Rajmali-22/fpga-zebra-crossing-camera/demo_photos/none_02.jpg

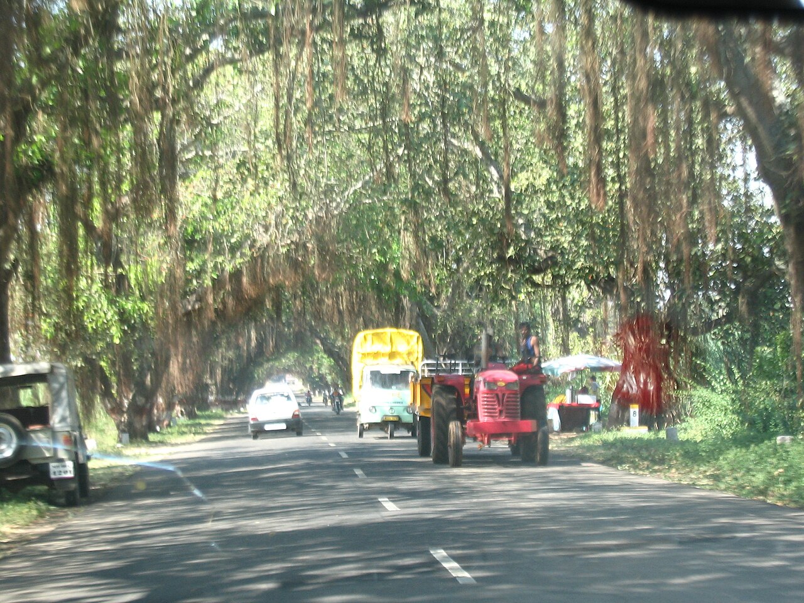
demo_photos/none_02.jpg
