Rajmali-22/fpga-zebra-crossing-camera/demo_photos/zebra_01.jpg

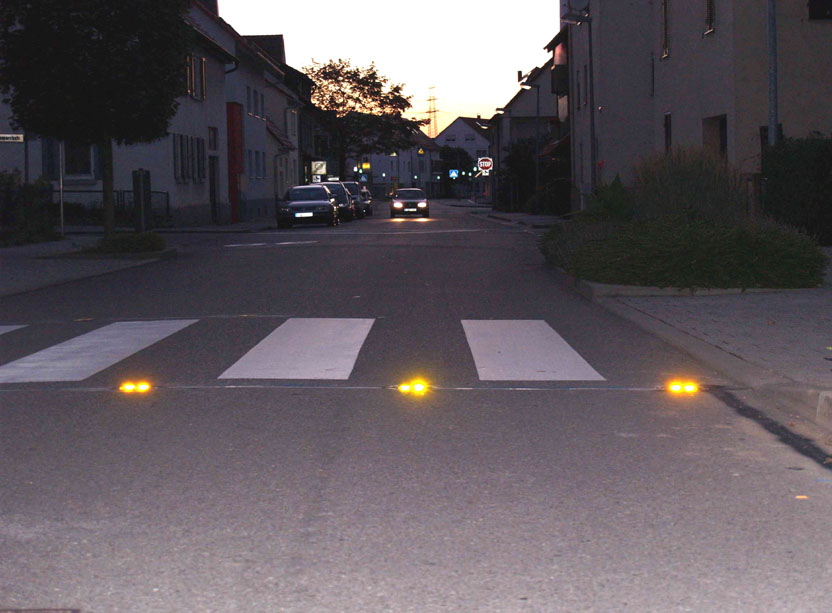
demo_photos/zebra_01.jpg
