Rajmali-22/fpga-zebra-crossing-camera/demo_photos/zebra_07.jpg

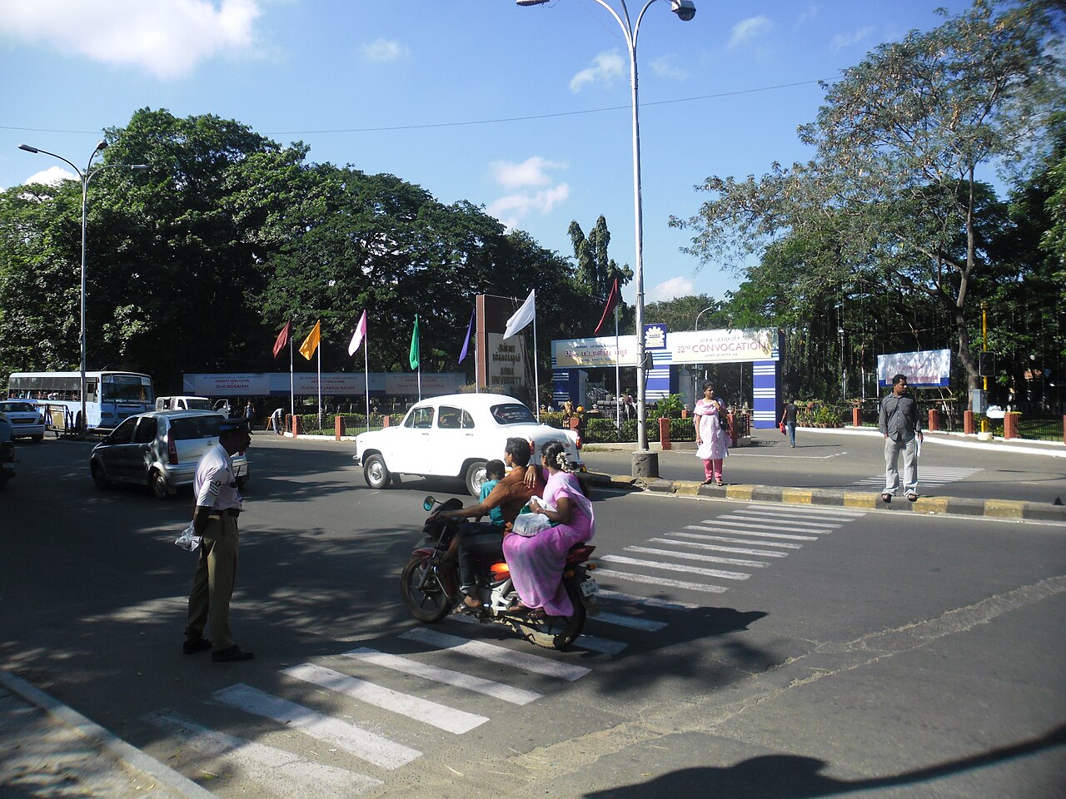
demo_photos/zebra_07.jpg
