Rajmali-22/fpga-zebra-crossing-camera/docs/fake_capture.png

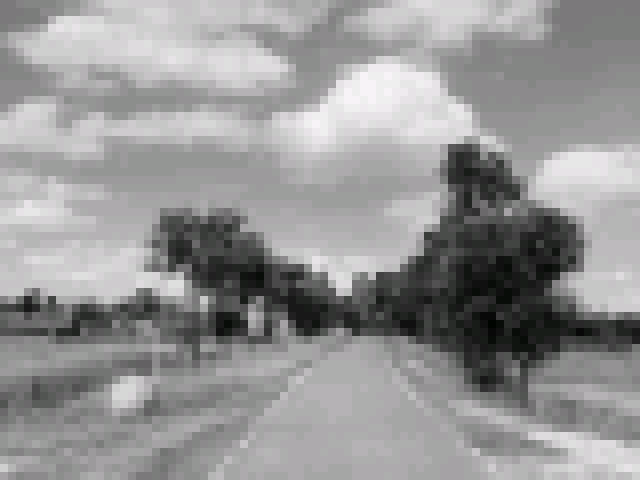
docs/fake_capture.png
