Rajmali-22/fpga-zebra-crossing-camera/docs/fig_architecture.png

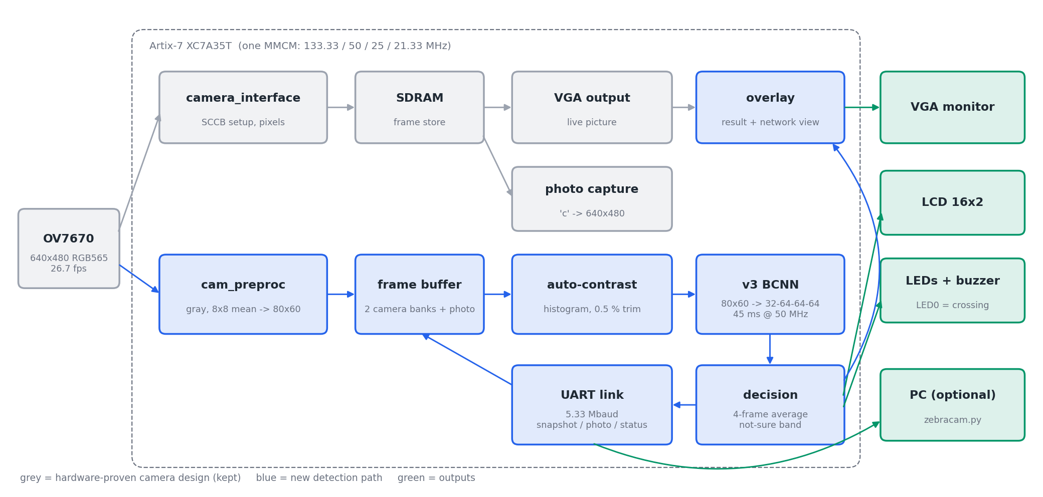
docs/fig_architecture.png
