Rajmali-22/fpga-zebra-crossing-camera/docs/fig_real_frame.png

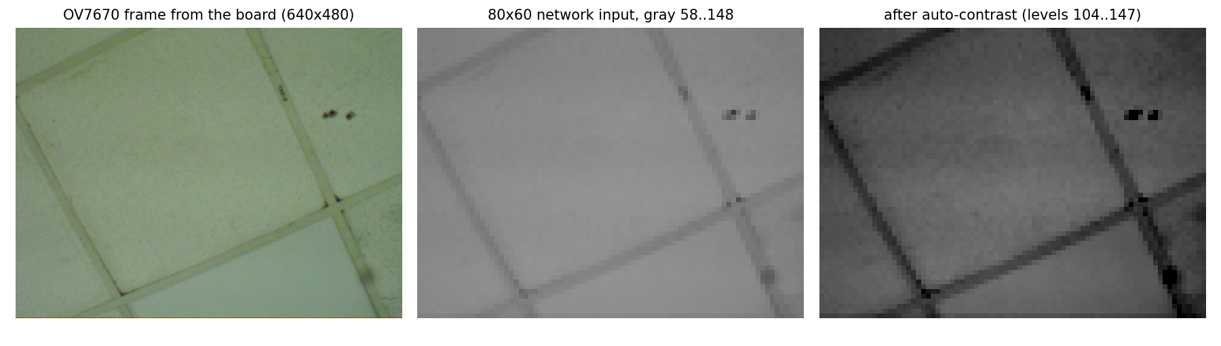
docs/fig_real_frame.png
