Rajmali-22/fpga-zebra-crossing-camera/docs/fig_robustness.png

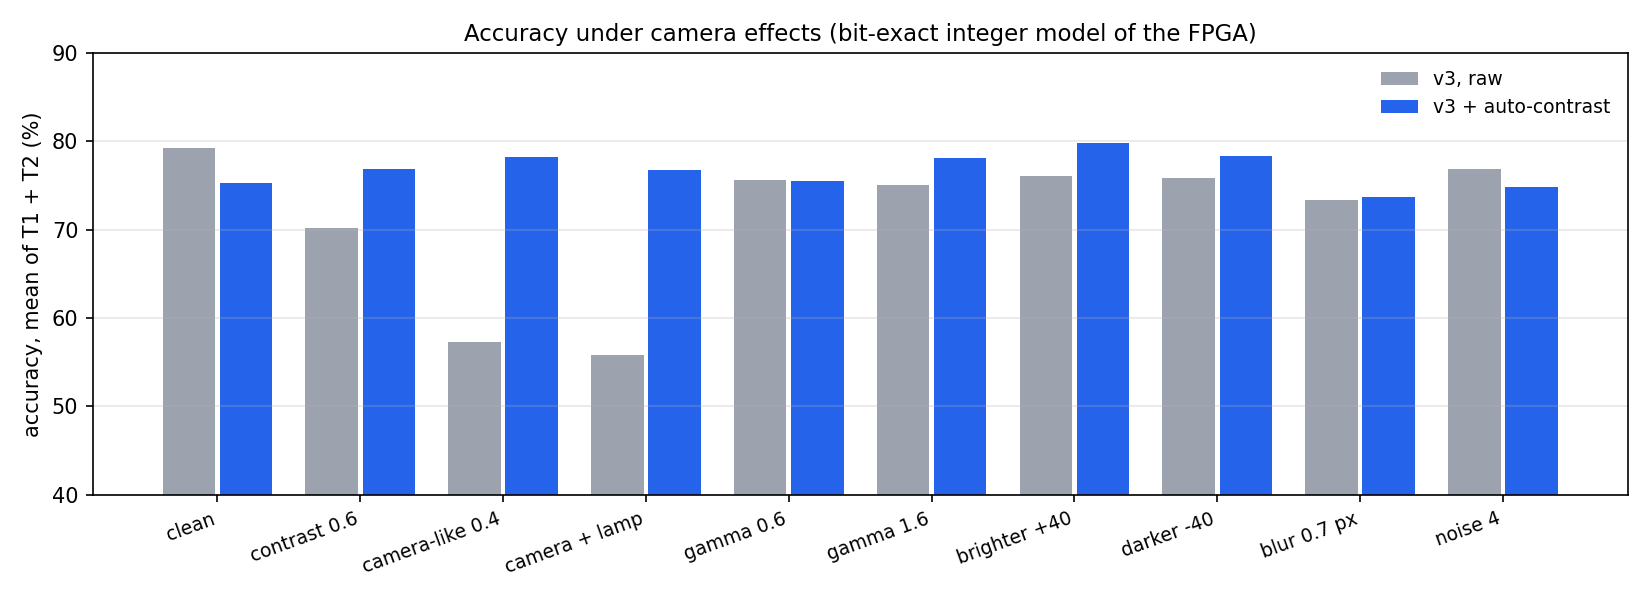
docs/fig_robustness.png
