Rajmali-22/fpga-zebra-crossing-camera/docs/paper/fig2_real_frame.png

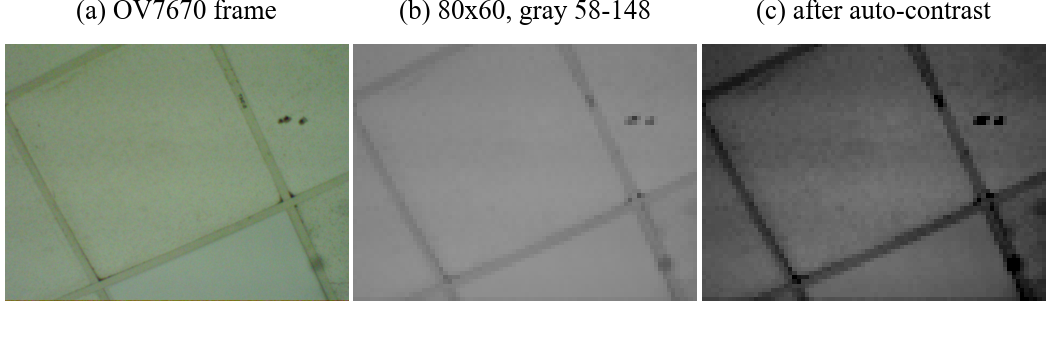
docs/paper/fig2_real_frame.png
