Rajmali-22/fpga-zebra-crossing-camera/docs/paper/fig3_robustness.png

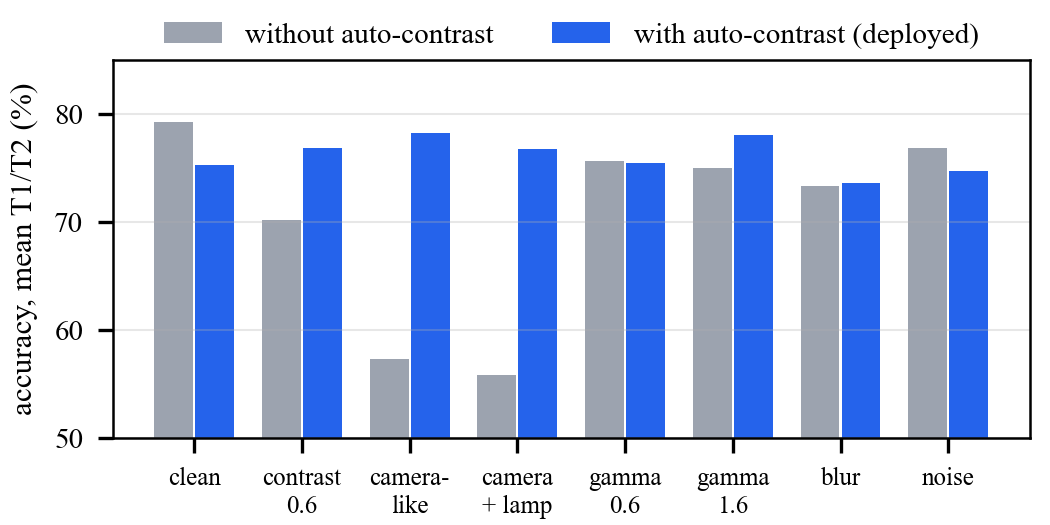
docs/paper/fig3_robustness.png
