Rajmali-22/fpga-zebra-crossing-camera/docs/paper/fig4_coverage.png

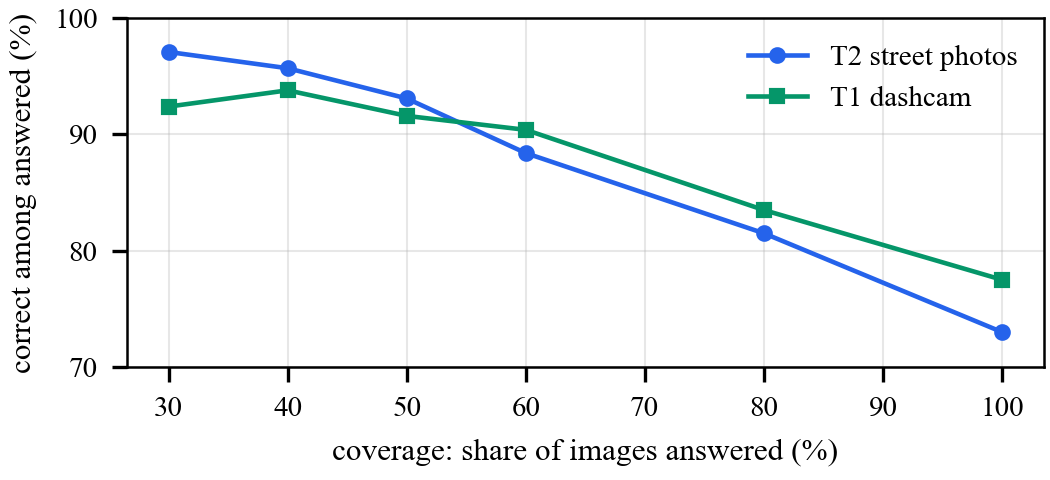
docs/paper/fig4_coverage.png
