Rajmali-22/fpga-zebra-crossing-camera/docs/paper/fig5_energy.png

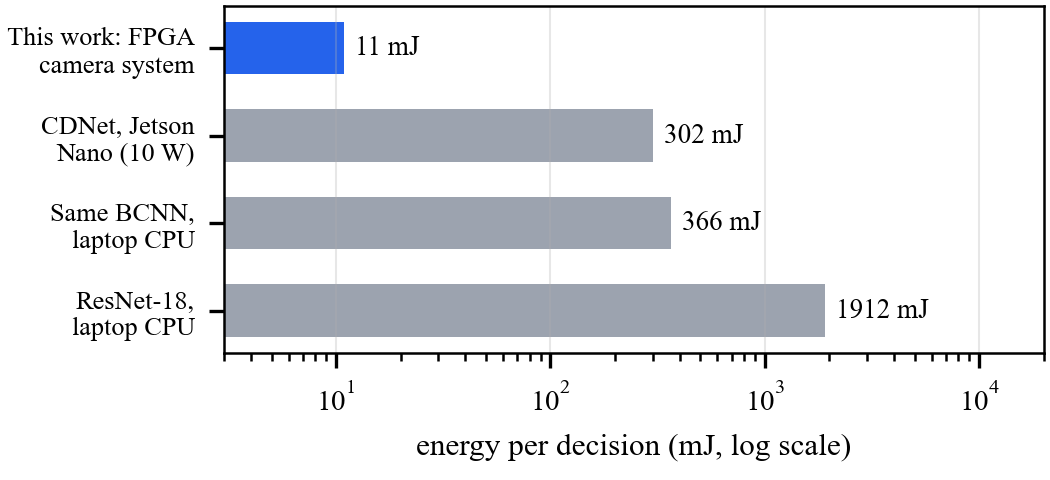
docs/paper/fig5_energy.png
