Rajmali-22/fpga-zebra-crossing-camera/docs/paper/fig7_margins.png

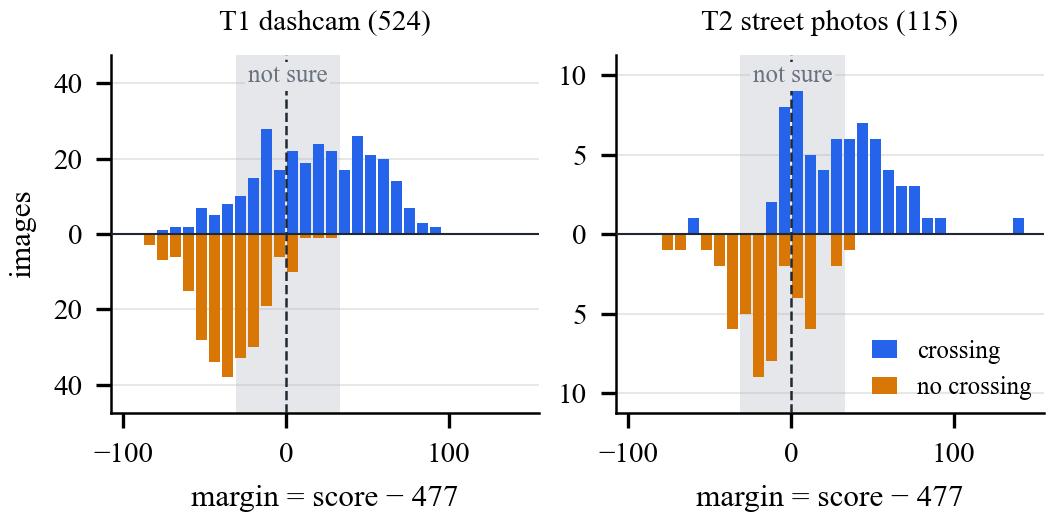
docs/paper/fig7_margins.png
