Rajmali-22/fpga-zebra-crossing-camera/docs/real_capture_net80x60.png

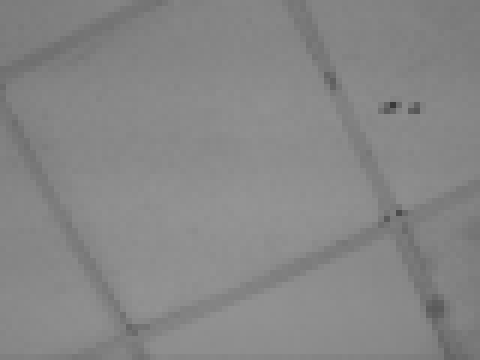
docs/real_capture_net80x60.png
