Rajmali-22/fpga-zebra-crossing-camera/docs/vga_photo.png

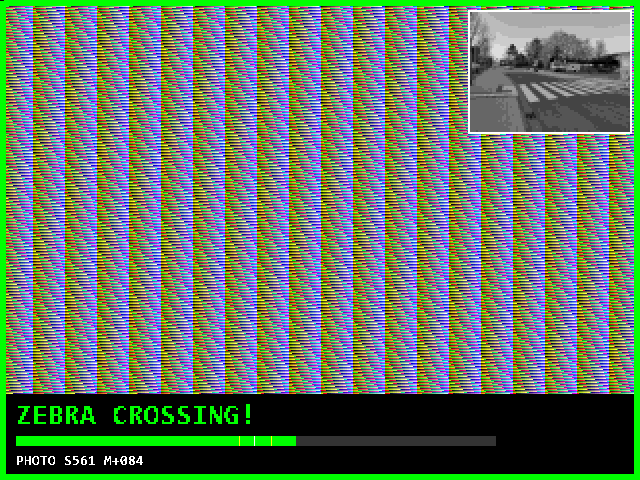
docs/vga_photo.png
