Rajmali-22/fpga-zebra-crossing-camera/docs/vga_state0_src0.png

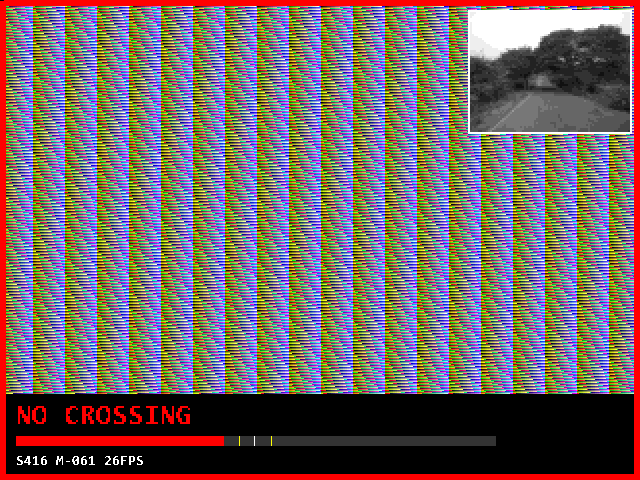
docs/vga_state0_src0.png
