Rajmali-22/fpga-zebra-crossing-camera/vectors/t2/test_labels.txt

1
1
1
1
1
1
1
1
1
1
1
1
1
1
1
1
1
1
1
1
1
1
1
1
1
1
1
1
1
1
1
1
1
1
1
1
1
1
1
1
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
