Rajmali-22/fpga-zebra-crossing-camera/vivado/sdram_loc.xdc

## SDRAM I/O registers pinned to the slice sites they had in the hardware-proven
## build (soc/capture, 6 Aug 2026), so the 133 MHz SDRAM I/O timing is reproduced.
set_property BEL SLICEM.BFF [get_cells {m1/m0/s_addr_q_reg[12]}]
set_property LOC SLICE_X8Y70 [get_cells {m1/m0/s_addr_q_reg[12]}]
set_property BEL SLICEM.AFF [get_cells {m1/m0/s_addr_q_reg[11]}]
set_property LOC SLICE_X8Y70 [get_cells {m1/m0/s_addr_q_reg[11]}]
set_property BEL SLICEL.AFF [get_cells {m1/m0/s_addr_q_reg[10]}]
set_property LOC SLICE_X7Y75 [get_cells {m1/m0/s_addr_q_reg[10]}]
set_property BEL SLICEM.A5FF [get_cells {m1/m0/s_addr_q_reg[9]}]
set_property LOC SLICE_X8Y70 [get_cells {m1/m0/s_addr_q_reg[9]}]
set_property BEL SLICEM.D5FF [get_cells {m1/m0/s_addr_q_reg[8]}]
set_property LOC SLICE_X8Y70 [get_cells {m1/m0/s_addr_q_reg[8]}]
set_property BEL SLICEM.DFF [get_cells {m1/m0/s_addr_q_reg[7]}]
set_property LOC SLICE_X8Y70 [get_cells {m1/m0/s_addr_q_reg[7]}]
set_property BEL SLICEM.C5FF [get_cells {m1/m0/s_addr_q_reg[6]}]
set_property LOC SLICE_X8Y70 [get_cells {m1/m0/s_addr_q_reg[6]}]
set_property BEL SLICEM.B5FF [get_cells {m1/m0/s_addr_q_reg[5]}]
set_property LOC SLICE_X8Y70 [get_cells {m1/m0/s_addr_q_reg[5]}]
set_property BEL SLICEM.B5FF [get_cells {m1/m0/s_addr_q_reg[4]}]
set_property LOC SLICE_X8Y71 [get_cells {m1/m0/s_addr_q_reg[4]}]
set_property BEL SLICEM.CFF [get_cells {m1/m0/s_addr_q_reg[3]}]
set_property LOC SLICE_X8Y70 [get_cells {m1/m0/s_addr_q_reg[3]}]
set_property BEL SLICEM.BFF [get_cells {m1/m0/s_addr_q_reg[2]}]
set_property LOC SLICE_X8Y71 [get_cells {m1/m0/s_addr_q_reg[2]}]
set_property BEL SLICEM.A5FF [get_cells {m1/m0/s_addr_q_reg[1]}]
set_property LOC SLICE_X8Y71 [get_cells {m1/m0/s_addr_q_reg[1]}]
set_property BEL SLICEM.AFF [get_cells {m1/m0/s_addr_q_reg[0]}]
set_property LOC SLICE_X8Y71 [get_cells {m1/m0/s_addr_q_reg[0]}]
set_property BEL SLICEM.C5FF [get_cells {m1/m0/s_ba_q_reg[1]}]
set_property LOC SLICE_X8Y71 [get_cells {m1/m0/s_ba_q_reg[1]}]
set_property BEL SLICEM.CFF [get_cells {m1/m0/s_ba_q_reg[0]}]
set_property LOC SLICE_X8Y71 [get_cells {m1/m0/s_ba_q_reg[0]}]
set_property BEL SLICEM.AFF [get_cells {m1/m0/tri_q_reg}]
set_property LOC SLICE_X2Y74 [get_cells {m1/m0/tri_q_reg}]
set_property BEL SLICEL.DFF [get_cells {m1/m0/f2s_data_q_reg[15]}]
set_property LOC SLICE_X1Y82 [get_cells {m1/m0/f2s_data_q_reg[15]}]
set_property BEL SLICEL.CFF [get_cells {m1/m0/s2f_data_q_reg[15]}]
set_property LOC SLICE_X1Y71 [get_cells {m1/m0/s2f_data_q_reg[15]}]
set_property BEL SLICEL.CFF [get_cells {m1/m0/f2s_data_q_reg[14]}]
set_property LOC SLICE_X1Y82 [get_cells {m1/m0/f2s_data_q_reg[14]}]
set_property BEL SLICEL.BFF [get_cells {m1/m0/s2f_data_q_reg[14]}]
set_property LOC SLICE_X3Y72 [get_cells {m1/m0/s2f_data_q_reg[14]}]
set_property BEL SLICEL.BFF [get_cells {m1/m0/f2s_data_q_reg[13]}]
set_property LOC SLICE_X1Y82 [get_cells {m1/m0/f2s_data_q_reg[13]}]
set_property BEL SLICEL.AFF [get_cells {m1/m0/s2f_data_q_reg[13]}]
set_property LOC SLICE_X3Y72 [get_cells {m1/m0/s2f_data_q_reg[13]}]
set_property BEL SLICEL.AFF [get_cells {m1/m0/f2s_data_q_reg[12]}]
set_property LOC SLICE_X1Y82 [get_cells {m1/m0/f2s_data_q_reg[12]}]
set_property BEL SLICEL.BFF [get_cells {m1/m0/s2f_data_q_reg[12]}]
set_property LOC SLICE_X1Y71 [get_cells {m1/m0/s2f_data_q_reg[12]}]
set_property BEL SLICEL.CFF [get_cells {m1/m0/f2s_data_q_reg[11]}]
set_property LOC SLICE_X1Y80 [get_cells {m1/m0/f2s_data_q_reg[11]}]
set_property BEL SLICEL.CFF [get_cells {m1/m0/s2f_data_q_reg[11]}]
set_property LOC SLICE_X3Y71 [get_cells {m1/m0/s2f_data_q_reg[11]}]
set_property BEL SLICEL.BFF [get_cells {m1/m0/f2s_data_q_reg[10]}]
set_property LOC SLICE_X1Y80 [get_cells {m1/m0/f2s_data_q_reg[10]}]
set_property BEL SLICEL.AFF [get_cells {m1/m0/s2f_data_q_reg[10]}]
set_property LOC SLICE_X1Y71 [get_cells {m1/m0/s2f_data_q_reg[10]}]
set_property BEL SLICEL.DFF [get_cells {m1/m0/f2s_data_q_reg[9]}]
set_property LOC SLICE_X0Y80 [get_cells {m1/m0/f2s_data_q_reg[9]}]
set_property BEL SLICEL.BFF [get_cells {m1/m0/s2f_data_q_reg[9]}]
set_property LOC SLICE_X0Y70 [get_cells {m1/m0/s2f_data_q_reg[9]}]
set_property BEL SLICEL.CFF [get_cells {m1/m0/f2s_data_q_reg[8]}]
set_property LOC SLICE_X0Y80 [get_cells {m1/m0/f2s_data_q_reg[8]}]
set_property BEL SLICEL.AFF [get_cells {m1/m0/s2f_data_q_reg[8]}]
set_property LOC SLICE_X0Y70 [get_cells {m1/m0/s2f_data_q_reg[8]}]
set_property BEL SLICEL.DFF [get_cells {m1/m0/f2s_data_q_reg[7]}]
set_property LOC SLICE_X0Y82 [get_cells {m1/m0/f2s_data_q_reg[7]}]
set_property BEL SLICEL.DFF [get_cells {m1/m0/s2f_data_q_reg[7]}]
set_property LOC SLICE_X3Y72 [get_cells {m1/m0/s2f_data_q_reg[7]}]
set_property BEL SLICEL.CFF [get_cells {m1/m0/f2s_data_q_reg[6]}]
set_property LOC SLICE_X0Y82 [get_cells {m1/m0/f2s_data_q_reg[6]}]
set_property BEL SLICEL.DFF [get_cells {m1/m0/s2f_data_q_reg[6]}]
set_property LOC SLICE_X0Y71 [get_cells {m1/m0/s2f_data_q_reg[6]}]
set_property BEL SLICEL.BFF [get_cells {m1/m0/f2s_data_q_reg[5]}]
set_property LOC SLICE_X0Y82 [get_cells {m1/m0/f2s_data_q_reg[5]}]
set_property BEL SLICEL.CFF [get_cells {m1/m0/s2f_data_q_reg[5]}]
set_property LOC SLICE_X0Y71 [get_cells {m1/m0/s2f_data_q_reg[5]}]
set_property BEL SLICEL.AFF [get_cells {m1/m0/f2s_data_q_reg[4]}]
set_property LOC SLICE_X0Y82 [get_cells {m1/m0/f2s_data_q_reg[4]}]
set_property BEL SLICEL.CFF [get_cells {m1/m0/s2f_data_q_reg[4]}]
set_property LOC SLICE_X3Y72 [get_cells {m1/m0/s2f_data_q_reg[4]}]
set_property BEL SLICEL.BFF [get_cells {m1/m0/f2s_data_q_reg[3]}]
set_property LOC SLICE_X0Y80 [get_cells {m1/m0/f2s_data_q_reg[3]}]
set_property BEL SLICEL.DFF [get_cells {m1/m0/s2f_data_q_reg[3]}]
set_property LOC SLICE_X3Y71 [get_cells {m1/m0/s2f_data_q_reg[3]}]
set_property BEL SLICEL.AFF [get_cells {m1/m0/f2s_data_q_reg[2]}]
set_property LOC SLICE_X0Y80 [get_cells {m1/m0/f2s_data_q_reg[2]}]
set_property BEL SLICEL.BFF [get_cells {m1/m0/s2f_data_q_reg[2]}]
set_property LOC SLICE_X0Y71 [get_cells {m1/m0/s2f_data_q_reg[2]}]
set_property BEL SLICEL.DFF [get_cells {m1/m0/f2s_data_q_reg[1]}]
set_property LOC SLICE_X1Y80 [get_cells {m1/m0/f2s_data_q_reg[1]}]
set_property BEL SLICEL.AFF [get_cells {m1/m0/s2f_data_q_reg[1]}]
set_property LOC SLICE_X0Y71 [get_cells {m1/m0/s2f_data_q_reg[1]}]
set_property BEL SLICEL.AFF [get_cells {m1/m0/f2s_data_q_reg[0]}]
set_property LOC SLICE_X1Y80 [get_cells {m1/m0/f2s_data_q_reg[0]}]
set_property BEL SLICEL.BFF [get_cells {m1/m0/s2f_data_q_reg[0]}]
set_property LOC SLICE_X3Y71 [get_cells {m1/m0/s2f_data_q_reg[0]}]
set_property BEL SLICEM.BFF [get_cells {m1/m0/cmd_q_reg[3]}]
set_property LOC SLICE_X2Y75 [get_cells {m1/m0/cmd_q_reg[3]}]
set_property BEL SLICEM.AFF [get_cells {m1/m0/cmd_q_reg[2]}]
set_property LOC SLICE_X2Y75 [get_cells {m1/m0/cmd_q_reg[2]}]
set_property BEL SLICEL.AFF [get_cells {m1/m0/cmd_q_reg[1]}]
set_property LOC SLICE_X3Y73 [get_cells {m1/m0/cmd_q_reg[1]}]
set_property BEL SLICEL.AFF [get_cells {m1/m0/cmd_q_reg[0]}]
set_property LOC SLICE_X5Y75 [get_cells {m1/m0/cmd_q_reg[0]}]
