Rajmali-22/fpga-zebra-crossing-camera/rtl/camera/camera_interface.v

`timescale 1ns / 1ps

  module camera_interface(
	input wire clk,clk_100,rst_n,
	input wire[3:0] key, //key[1:0] for brightness control , key[3:2] for contrast control
	//asyn_fifo IO
	input wire rd_en,
	output wire[9:0] data_count_r,
	output wire[15:0] dout,
	//frame-capture control (see frame_capture.v)
	input wire cap_pause,  //1 = park the pixel FSM at a frame boundary, stop feeding the fifo
	input wire fifo_flush, //1 = clear the camera->sdram fifo (only pulsed while paused)
	//camera pinouts
	input wire cmos_pclk,cmos_href,cmos_vsync,
	input wire[7:0] cmos_db,
	inout cmos_sda,cmos_scl, //i2c comm wires
	output wire cmos_rst_n, cmos_pwdn,
	//Debugging
	output wire[3:0] led
    );
	 //FSM state declarations
	 localparam idle=0,
					start_sccb=1,
					write_address=2,
					write_data=3,
					digest_loop=4,
					delay=5,
					vsync_fedge=6,
					byte1=7,
					byte2=8,
					fifo_write=9,
					stopping=10;
					
	 localparam wait_init=0,
					sccb_idle=1,
					sccb_address=2,
					sccb_data=3,
					sccb_stop=4;
					
	 localparam MSG_INDEX=77; //number of the last index to be digested by SCCB
	 
	 
	 
	 reg[3:0] state_q=0,state_d;
	 reg[2:0] sccb_state_q=0,sccb_state_d;
	 reg[7:0] addr_q,addr_d;
	 reg[7:0] data_q,data_d;
	 reg[7:0] brightness_q,brightness_d;
	 reg[7:0] contrast_q,contrast_d;
	 reg start,stop;
	 reg[7:0] wr_data;
	 wire rd_tick;
	 wire[1:0] ack;
	 wire[7:0] rd_data;
	 wire[3:0] state;
	 reg[3:0] led_q=0,led_d; 
	 reg[27:0] delay_q=0,delay_d;
	 reg start_delay_q=0,start_delay_d;
	 reg delay_finish;
	 reg[15:0] message[250:0];
	 reg[7:0] message_index_q=0,message_index_d;
	 reg[15:0] pixel_q,pixel_d;
	 reg wr_en;
	 wire full;
	 wire key0_tick,key1_tick,key2_tick,key3_tick;
	 
	 //buffer for all inputs coming from the camera
	 reg pclk_1,pclk_2,href_1,href_2,vsync_1,vsync_2;

	 
	 initial begin //collection of all adddresses and values to be written in the camera
				//{address,data}
	 message[0]=16'h12_80;  //reset all register to default values
	 message[1]=16'h12_04;  //set output format to RGB
	 message[2]=16'h15_20;  //pclk will not toggle during horizontal blank
	 message[3]=16'h40_d0;	//RGB565
	 
	// These are values scalped from https://github.com/jonlwowski012/OV7670_NEXYS4_Verilog/blob/master/ov7670_registers_verilog.v
    message[4]= 16'h12_04; // COM7,     set RGB color output
    message[5]= 16'h11_80; // CLKRC     internal PLL matches input clock
    message[6]= 16'h0C_00; // COM3,     default settings
    message[7]= 16'h3E_00; // COM14,    no scaling, normal pclock
    message[8]= 16'h04_00; // COM1,     disable CCIR656
    message[9]= 16'h40_d0; //COM15,     RGB565, full output range
    message[10]= 16'h3a_04; //TSLB       set correct output data sequence (magic)
	 message[11]= 16'h14_18; //COM9       MAX AGC value x4 0001_1000
    message[12]= 16'h4F_B3; //MTX1       all of these are magical matrix coefficients
    message[13]= 16'h50_B3; //MTX2
    message[14]= 16'h51_00; //MTX3
    message[15]= 16'h52_3d; //MTX4
    message[16]= 16'h53_A7; //MTX5
    message[17]= 16'h54_E4; //MTX6
    message[18]= 16'h58_9E; //MTXS
    message[19]= 16'h3D_C0; //COM13      sets gamma enable, does not preserve reserved bits, may be wrong?
    message[20]= 16'h17_14; //HSTART     start high 8 bits
    message[21]= 16'h18_02; //HSTOP      stop high 8 bits //these kill the odd colored line
    message[22]= 16'h32_80; //HREF       edge offset
    message[23]= 16'h19_03; //VSTART     start high 8 bits
    message[24]= 16'h1A_7B; //VSTOP      stop high 8 bits
    message[25]= 16'h03_0A; //VREF       vsync edge offset
    message[26]= 16'h0F_41; //COM6       reset timings
    message[27]= 16'h1E_00; //MVFP       disable mirror / flip //might have magic value of 03
    message[28]= 16'h33_0B; //CHLF       //magic value from the internet
    message[29]= 16'h3C_78; //COM12      no HREF when VSYNC low
    message[30]= 16'h69_00; //GFIX       fix gain control
    message[31]= 16'h74_00; //REG74      Digital gain control
    message[32]= 16'hB0_84; //RSVD       magic value from the internet *required* for good color
    message[33]= 16'hB1_0c; //ABLC1
    message[34]= 16'hB2_0e; //RSVD       more magic internet values
    message[35]= 16'hB3_80; //THL_ST
    //begin mystery scaling numbers
    message[36]= 16'h70_3a;
    message[37]= 16'h71_35;
    message[38]= 16'h72_11;
    message[39]= 16'h73_f0;
    message[40]= 16'ha2_02;
    //gamma curve values
    message[41]= 16'h7a_20;
    message[42]= 16'h7b_10;
    message[43]= 16'h7c_1e;
    message[44]= 16'h7d_35;
    message[45]= 16'h7e_5a;
    message[46]= 16'h7f_69;
    message[47]= 16'h80_76;
    message[48]= 16'h81_80;
    message[49]= 16'h82_88;
    message[50]= 16'h83_8f;
    message[51]= 16'h84_96;
    message[52]= 16'h85_a3;
    message[53]= 16'h86_af;
    message[54]= 16'h87_c4;
    message[55]= 16'h88_d7;
    message[56]= 16'h89_e8;
    //AGC and AEC
    message[57]= 16'h13_e0; //COM8, disable AGC / AEC
    message[58]= 16'h00_00; //set gain reg to 0 for AGC
    message[59]= 16'h10_00; //set ARCJ reg to 0
    message[60]= 16'h0d_40; //magic reserved bit for COM4
    message[61]= 16'h14_18; //COM9, 4x gain + magic bit
    message[62]= 16'ha5_05; // BD50MAX
    message[63]= 16'hab_07; //DB60MAX
    message[64]= 16'h24_95; //AGC upper limit
    message[65]= 16'h25_33; //AGC lower limit
    message[66]= 16'h26_e3; //AGC/AEC fast mode op region
    message[67]= 16'h9f_78; //HAECC1
    message[68]= 16'ha0_68; //HAECC2
    message[69]= 16'ha1_03; //magic
    message[70]= 16'ha6_d8; //HAECC3
    message[71]= 16'ha7_d8; //HAECC4
    message[72]= 16'ha8_f0; //HAECC5
    message[73]= 16'ha9_90; //HAECC6
    message[74]= 16'haa_94; //HAECC7
    message[75]= 16'h13_e5; //COM8, enable AGC / AEC
	 message[76]= 16'h1E_23; //Mirror Image
	 message[77]= 16'h69_06; //gain of RGB(manually adjusted)
  end
	 
	 //register operations
	 always @(posedge clk_100,negedge rst_n) begin
		if(!rst_n) begin
			state_q<=0;
			led_q<=0;
			delay_q<=0;
			start_delay_q<=0;
			message_index_q<=0;
			pixel_q<=0;
			
			sccb_state_q<=0;
			addr_q<=0;
			data_q<=0;
			brightness_q<=0;
			contrast_q<=0;
		end
		else begin
			state_q<=state_d;
			led_q<=led_d;
			delay_q<=delay_d;
			start_delay_q<=start_delay_d;
			message_index_q<=message_index_d;			
			pclk_1<=cmos_pclk; 
			pclk_2<=pclk_1;
			href_1<=cmos_href;
			href_2<=href_1;
			vsync_1<=cmos_vsync;
			vsync_2<=vsync_1;
			pixel_q<=pixel_d;
			
			sccb_state_q<=sccb_state_d;
			addr_q<=addr_d;
			data_q<=data_d;
			brightness_q<=brightness_d;
			contrast_q<=contrast_d;
		end
	 end
	 	 
	 
	 //FSM next-state logics
	 always @* begin
		state_d=state_q;
		led_d=led_q;
		start=0;
		stop=0;
		wr_data=0;
		start_delay_d=start_delay_q;
		delay_d=delay_q;
		delay_finish=0;
		message_index_d=message_index_q;
		pixel_d=pixel_q;
		wr_en=0;
		
		sccb_state_d=sccb_state_q;
		addr_d=addr_q;
		data_d=data_q;
		brightness_d=brightness_q;
		contrast_d=contrast_q;
		
		//delay logic  
		if(start_delay_q) delay_d=delay_q+1'b1;
		if(delay_q[16] && message_index_q!=(MSG_INDEX+1) && (state_q!=start_sccb))  begin  //delay between SCCB transmissions (0.66ms)
			delay_finish=1;
			start_delay_d=0;
			delay_d=0;
		end
		else if((delay_q[26] && message_index_q==(MSG_INDEX+1)) || (delay_q[26] && state_q==start_sccb)) begin //delay BEFORE SCCB transmission, AFTER SCCB transmission, and BEFORE retrieving pixel data from camera (0.67s)
			delay_finish=1;
			start_delay_d=0;
			delay_d=0;
		end
		
		case(state_q) 
		
					////////Begin: Setting register values of the camera via SCCB///////////
					
			  idle:  if(delay_finish) begin //idle for 0.6s to start-up the camera
							state_d=start_sccb; 
							start_delay_d=0;
						end
						else start_delay_d=1;

		start_sccb:  begin   //start of SCCB transmission
							start=1;
							wr_data=8'h42; //slave address of OV7670 for write
							state_d=write_address;						
						end
	 write_address: if(ack==2'b11) begin 
							wr_data=message[message_index_q][15:8]; //write address
							state_d=write_data;
						end
		 write_data: if(ack==2'b11) begin 
							wr_data=message[message_index_q][7:0]; //write data
							state_d=digest_loop;
						end
	  digest_loop: if(ack==2'b11) begin //stop sccb transmission
							stop=1;
							start_delay_d=1;
							message_index_d=message_index_q+1'b1;
							state_d=delay;
						end
			  delay: begin
							if(message_index_q==(MSG_INDEX+1) && delay_finish) begin 
								state_d=vsync_fedge; //if all messages are already digested, proceed to retrieving camera pixel data
								led_d=4'b0110;
							end
							else if(state==0 && delay_finish) state_d=start_sccb; //small delay before next SCCB transmission(if all messages are not yet digested)
						end
			  
			  

				///////////////Begin: Retrieving Pixel Data from Camera to be Stored to SDRAM/////////////////
				
		vsync_fedge: if(vsync_1==0 && vsync_2==1) state_d=byte1; //vsync falling edge means new frame is incoming
				byte1: if(pclk_1==1 && pclk_2==0 && href_1==1 && href_2==1) begin //rising edge of pclk means new pixel data(first byte of 16-bit pixel RGB565) is available at output
								pixel_d[15:8]=cmos_db;
								state_d=byte2;
						 end
						 else if(vsync_1==1 && vsync_2==1) begin
							state_d=vsync_fedge;
						 end
				byte2: if(pclk_1==1 && pclk_2==0 && href_1==1 && href_2==1) begin //rising edge of pclk means new pixel data(second byte of 16-bit pixel RGB565) is available at output
								pixel_d[7:0]=cmos_db;
								state_d=fifo_write;
						 end
						 else if(vsync_1==1 && vsync_2==1) begin
							state_d=vsync_fedge;
						 end
		 fifo_write: begin //write the 16-bit data to asynchronous fifo to be retrieved later by SDRAM
								wr_en=1;
								state_d=byte1;
								if(full) led_d=4'b1001; //debugging led
						 end
		default: state_d=idle;
		endcase
		
		//Logic for increasing/decreasing brightness and contrast via the 4 keybuttons
		case(sccb_state_q)
			wait_init: if(state_q==byte1) begin //wait for initial SCCB transmission to finish
							sccb_state_d=sccb_idle;
							addr_d=0;
							data_d=0;
							brightness_d=8'h00; 
							contrast_d=8'h40;
						  end
			sccb_idle: if(state==0) begin //wait for any pushbutton
								if(key0_tick) begin//increase brightness
									brightness_d=(brightness_q[7]==1)? brightness_q-1:brightness_q+1;
									if(brightness_q==8'h80) brightness_d=0;
									start=1;
									wr_data=8'h42; //slave address of OV7670 for write
									addr_d=8'h55; //brightness control address
									data_d=brightness_d;
									sccb_state_d=sccb_address;
									led_d=0;
								end
								if(key1_tick) begin //decrease brightness
									brightness_d=(brightness_q[7]==1)? brightness_q+1:brightness_q-1;
									if(brightness_q==0) brightness_d=8'h80;
									start=1;
									wr_data=8'h42; 
									addr_d=8'h55;
									data_d=brightness_d;
									sccb_state_d=sccb_address;
									led_d=0;
								end
								else if(key2_tick) begin //increase contrast
									contrast_d=contrast_q+1;
									start=1;
									wr_data=8'h42; //slave address of OV7670 for write
									addr_d=8'h56; //contrast control address
									data_d=contrast_d;
									sccb_state_d=sccb_address;
									led_d=0;
								end
								else if(key3_tick) begin //change contrast
									contrast_d=contrast_q-1;
									start=1;
									wr_data=8'h42;
									addr_d=8'h56;
									data_d=contrast_d;
									sccb_state_d=sccb_address;
									led_d=0;
								end
						  end
		sccb_address: if(ack==2'b11) begin 
							wr_data=addr_q; //write address
							sccb_state_d=sccb_data;
						end
		  sccb_data: if(ack==2'b11) begin 
							wr_data=data_q; //write databyte
							sccb_state_d=sccb_stop;
						 end
		  sccb_stop: if(ack==2'b11) begin //stop
							stop=1;
							sccb_state_d=sccb_idle;
							led_d=4'b1001;
						 end
			 default: sccb_state_d=wait_init;
		endcase

		//Frame-capture override: while a photo is being uploaded over UART we park the
		//pixel FSM at "vsync_fedge" and stop feeding the fifo. When cap_pause is released
		//the FSM waits for the next VSYNC falling edge, so it always restarts on a fresh
		//frame and stays aligned with the sdram write pointer (which is held at 0 meanwhile).
		if(cap_pause && (state_q==vsync_fedge || state_q==byte1 || state_q==byte2 || state_q==fifo_write)) begin
			state_d=vsync_fedge;
			wr_en=0;
		end

	 end
	 

	 assign cmos_pwdn=0; 
	 assign cmos_rst_n=1;
	 assign led=led_q;
	 
	 //module instantiations
	 i2c_top #(.freq(100_000)) m0
	(
		.clk(clk_100),
		.rst_n(rst_n),
		.start(start),
		.stop(stop),
		.wr_data(wr_data),
		.rd_tick(rd_tick), //ticks when read data from servant is ready,data will be taken from rd_data
		.ack(ack), //ack[1] ticks at the ack bit[9th bit],ack[0] asserts when ack bit is ACK,else NACK
		.rd_data(rd_data), 
		.scl(cmos_scl),
		.sda(cmos_sda),
		.state(state)
    ); 
	 
	 
	 //XCLK now comes from the MMCM in clk_rst.v (forwarded by an ODDR in top.v)
	 
	
	/*asyn_fifo m2 //buffer between camera and SDRAM
	(
	  .rst({!rst_n}), // input rst
	  .wr_clk(clk_100), // input wr_clk [CAMERA]
	  .rd_clk(clk_100), // input rd_clk [SDRAM]
	  .din(pixel_q), // input [15 : 0] din
	  .wr_en(wr_en), // input wr_en
	  .rd_en(rd_en), // input rd_en
	  .dout(dout), // output [15 : 0] dout
	  .full(full), // output full
	  .empty(), // output empty
	  .rd_data_count(rd_data_count), // output [9 : 0] rd_data_count
	  .wr_data_count() // output [9 : 0] wr_data_count
	);*/
	asyn_fifo #(.DATA_WIDTH(16),.FIFO_DEPTH_WIDTH(10)) m2 //1024x16 FIFO mem
	(
		.rst_n(rst_n && !fifo_flush), //flushed once at the end of a capture to drop stale pixels
		.clk_write(clk_100),
		.clk_read(clk_100), //clock input from both domains
		.write(wr_en),
		.read(rd_en), 
		.data_write(pixel_q), //input FROM write clock domain
		.data_read(dout), //output TO read clock domain
		.full(full),
		.empty(), //full=sync to write domain clk , empty=sync to read domain clk
		.data_count_r(data_count_r) //asserted if fifo is equal or more than than half of its max capacity
    );
	
	debounce_explicit m3
	(
		.clk(clk_100),
		.rst_n(rst_n),
		.sw({!key[0]}),
		.db_level(),
		.db_tick(key0_tick)
    );
	 
	debounce_explicit m4
	(
		.clk(clk_100),
		.rst_n(rst_n),
		.sw({!key[1]}),
		.db_level(),
		.db_tick(key1_tick)
    );
	 
	 debounce_explicit m5
	(
		.clk(clk_100),
		.rst_n(rst_n),
		.sw({!key[2]}),
		.db_level(),
		.db_tick(key2_tick)
    );
	 
	 debounce_explicit m6
	(
		.clk(clk_100),
		.rst_n(rst_n),
		.sw({!key[3]}),
		.db_level(),
		.db_tick(key3_tick)
    );
	
endmodule
