Rajmali-22/fpga-zebra-crossing-camera/rtl/camera/sdram_interface.v

`timescale 1ns / 1ps

module sdram_interface(
	input clk,rst_n,
	//asyn_fifo IO
	input wire clk_vga, rd_en,
	input wire[9:0] data_count_r,
	input wire[15:0] f2s_data,
	output wire f2s_data_valid,
	output wire empty_fifo,
	output wire[15:0] dout,
	//frame-capture port (see frame_capture.v)
	input  wire        freeze,         //1 = stop camera->sdram writes, hold wr_addr at 0
	input  wire        cap_rd_req,     //capture engine wants one full-page burst read
	input  wire[14:0]  cap_rd_addr,
	output reg         cap_rd_ack,     //1-clk pulse: that burst read has been issued
	output wire[15:0]  cap_data,
	output wire        cap_data_valid,
	output reg         frame_sync,     //1-clk pulse: LAST burst of a frame was issued
	//controller to sdram
	output wire sdram_clk,
	output wire sdram_cke, 
	output wire sdram_cs_n, sdram_ras_n, sdram_cas_n, sdram_we_n, 
	output wire[12:0] sdram_addr,
	output wire[1:0] sdram_ba, 
	output wire[1:0] sdram_dqm, 
	inout[15:0] sdram_dq
    );
	 //FSM state declarations
	 localparam idle=0,
					burst_op=1;
					
	 reg state_q=0,state_d;	 
	 reg[14:0] wr_addr_q=0,wr_addr_d;
	 reg[14:0] rd_addr_q=0,rd_addr_d;
	 reg rw,rw_en;
	 reg[14:0] f_addr;
	 wire[15:0] s2f_data;
	 wire s2f_data_valid;
	 wire ready;
	 wire[9:0] data_count_w;
	 //remembers who owns the read burst that is currently in flight.
	 //Safe as a single flag: the controller only accepts a new operation when
	 //"ready" is high, which means the previous burst has already finished.
	 reg rd_is_cap_q=0,rd_is_cap_d;



	 //register operation
	 always @(posedge clk,negedge rst_n) begin
		if(!rst_n) begin
			state_q<=0;
			wr_addr_q<=0;
			rd_addr_q<=0;
			rd_is_cap_q<=0;
		end
		else begin
			state_q<=state_d;
			wr_addr_q<=wr_addr_d;
			rd_addr_q<=rd_addr_d;
			rd_is_cap_q<=rd_is_cap_d;
		end
	 end
	 
	 //FSM next-state declarations
	 always @* begin
		state_d=state_q;
		wr_addr_d=wr_addr_q;
		rd_addr_d=rd_addr_q;
		f_addr=0;
		rw=0;
		rw_en=0;
		cap_rd_ack=0;
		frame_sync=0;
		rd_is_cap_d=rd_is_cap_q;

		case(state_q)
			    idle: if(!freeze && data_count_r>512 && ready) begin //wait for the first 512 pixel-data to fill the asyn_fifo then burst-write it to sdram
							rw_en=1;
							rw=0;
							wr_addr_d=1;
							f_addr=wr_addr_q;
							state_d=burst_op;
						 end
			burst_op: if(ready) begin //choose whether to read the asyn_fifo of camera OR write to asyn_fifo of VGA
								if(!freeze && data_count_r>512) begin //asyn_fifo of camera is filled to 512 thus we can now burst-write(full-page has 512 data) it to SDRAM
									rw_en=1;
									rw=0;
									if(wr_addr_q==15'd599) frame_sync=1; //this burst completes one whole frame in sdram
									wr_addr_d=(wr_addr_q==599)? 0:wr_addr_q+1'b1; //One frame(640x480) fills the addresses 0-to-599
									f_addr=wr_addr_q;
								end
								else if(data_count_w<250) begin //asyn_fifo of VGA has only 250 pixel data left, we will now fill it by another 512 pixel data via burst reading the sdram
									rw_en=1;
									rw=1;
									rd_addr_d=(rd_addr_q==599)? 0:rd_addr_q+1'b1;
									f_addr=rd_addr_q;
									rd_is_cap_d=0; //this burst belongs to the VGA fifo
								end
								else if(cap_rd_req) begin //lowest priority: the UART capture engine. It only needs 600 bursts per photo so it never starves the VGA
									rw_en=1;
									rw=1;
									f_addr=cap_rd_addr;
									rd_is_cap_d=1; //this burst belongs to the capture fifo
									cap_rd_ack=1;
								end
						 end
			 default: state_d=idle;
		endcase

		//while a photo is being uploaded the frame in sdram must not be overwritten,
		//and the write pointer must sit at the start of a frame ready for live view to resume
		if(freeze) wr_addr_d=0;
	 end

	 //steer the read-burst data to whoever asked for it
	 assign cap_data=s2f_data;
	 assign cap_data_valid=s2f_data_valid && rd_is_cap_q;
	 
	 //module instantiations
	 sdram_controller m0(
		//fpga to controller
		.clk(clk), //clk=165MHz
		.rst_n(rst_n),  
		.rw(rw), // 1:read , 0:write
		.rw_en(rw_en), //must be asserted before read/write
		.f_addr(f_addr), //14:2=row(13)  , 1:0=bank(2) , no need for column address since full page mode will always start from zero and end with 511 words
		.f2s_data(f2s_data), //fpga-to-sdram data
		.s2f_data(s2f_data), //sdram to fpga data
		.s2f_data_valid(s2f_data_valid),  //asserts while  burst-reading(data is available at output UNTIL the next rising edge)
		.f2s_data_valid(f2s_data_valid), //asserts while burst-writing(data must be available at input BEFORE the next rising edge)
		.ready(ready), //"1" if sdram is available for nxt read/write operation
		//controller to sdram
		.s_clk(sdram_clk),
		.s_cke(sdram_cke), 
		.s_cs_n(sdram_cs_n),
		.s_ras_n(sdram_ras_n ), 
		.s_cas_n(sdram_cas_n),
		.s_we_n(sdram_we_n), 
		.s_addr(sdram_addr), 
		.s_ba(sdram_ba), 
		.LDQM(sdram_dqm[0]),
		.HDQM(sdram_dqm[1]),
		.s_dq(sdram_dq)
		); 
	
	asyn_fifo #(.DATA_WIDTH(16),.FIFO_DEPTH_WIDTH(10)) m2 //1024x16 FIFO mem
	(
		.rst_n(rst_n),
		.clk_write(clk),
		.clk_read(clk_vga),
		.write(s2f_data_valid && !rd_is_cap_q), //capture bursts must not land in the VGA fifo
		.read(rd_en),
		.data_write(s2f_data), //input FROM write clock domain
		.data_read(dout), //output TO read clock domain
		.full(),
		.empty(empty_fifo), //full=sync to write domain clk , empty=sync to read domain clk
		.data_count_w(data_count_w) 
    );
	 

endmodule
