Rajmali-22/fpga-zebra-crossing-camera/rtl/camera/vga_interface.v

`timescale 1ns / 1ps

module vga_interface(
	input wire clk_vga,rst_n, //25 MHz from the MMCM in clk_rst.v (the dcm_25MHz is gone)
	//asyn_fifo IO
	input wire empty_fifo,
	input wire[15:0] din,
	output reg rd_en,
	//overlay (vga_overlay.v): drawn over the camera picture where ov_en is high
	input wire ov_en,
	input wire[11:0] ov_rgb,
	output wire[11:0] pix_x,pix_y,
	//VGA output
	output reg[3:0] vga_out_r,
	output reg[3:0] vga_out_g,
	output reg[3:0] vga_out_b,
	output wire vga_out_vs,vga_out_hs
    );
	 //FSM state declarations
	 localparam delay=0,
					idle=1,
					display=2;
					
	 reg[1:0] state_q,state_d;
	 wire[11:0] pixel_x,pixel_y;
	 wire clk_out=clk_vga;
	 assign pix_x=pixel_x;
	 assign pix_y=pixel_y;

	 //register operations
	 always @(posedge clk_out,negedge rst_n) begin
		if(!rst_n) begin
			state_q<=delay;
		end
		else begin
			state_q<=state_d;
		end
	 end
	 
	 //FSM next-state logic
	 always @* begin
	 state_d=state_q;
	 rd_en=0;
	 vga_out_r=0;
	 vga_out_g=0;
	 vga_out_b=0;
		case(state_q)
		  delay: if(pixel_x==1 && pixel_y==1) state_d=idle; //delay of one frame(33ms) needed to start up the camera
			idle:  if(pixel_x==1 && pixel_y==0 && !empty_fifo) begin //wait for pixel-data coming from asyn_fifo 
							vga_out_r=din[15:12]; 
							vga_out_g=din[10:7];
							vga_out_b=din[4:1];
							rd_en=1;	
							state_d=display;
					end
		display: if(pixel_x>=1 && pixel_x<=640 && pixel_y<480) begin //we will continue to read the asyn_fifo as long as current pixel coordinate is inside the visible screen(640x480) 
						vga_out_r=din[15:12]; 
						vga_out_g=din[10:7];
						vga_out_b=din[4:1];
						rd_en=1;	
					end
			default: state_d=delay;
		endcase
		if(ov_en) begin //overlay (results, network input) on top of the camera picture
			vga_out_r=ov_rgb[11:8];
			vga_out_g=ov_rgb[7:4];
			vga_out_b=ov_rgb[3:0];
		end
	 end
	 
	 
	 

	
	//module instantiations
	vga_core m0
	(
		.clk(clk_out), //clock must be 25MHz for 640x480
		.rst_n(rst_n),  
		.hsync(vga_out_hs),
		.vsync(vga_out_vs),
		.video_on(),
		.pixel_x(pixel_x),
		.pixel_y(pixel_y)
	);	
	 


endmodule
